itead/FishTank/Hardware/rboard pro-BOM.xls

PART_NUMBER | Ref Des | Qty | PCS | Description
00.23.01.0006 | C5 | 1 | 1 | CAP 0603 X7R 50V K 10nF
00.23.01.0007 | C4 | 1 | 1 | CAP 0603 X7R 50V K 3.9nF
00.23.01.0009 | C2,C3,C10,C14,C20,C21,C22,C23,C24,C28,C30,C31 | 12 | 1 | CAP 0603 X7R 50V K 100nF
00.23.01.0011 | C11,C12,C15,C18 | 4 | 1 | CAP 0603 NP0 50V J 12pF
00.23.01.0016 | C17,C29 | 2 | 1 | CAP 0603 X5R 25V K 10uF
00.23.03.0000 | C6,C7,C8,C13,C19,C25 | 6 | 1 | CAP 1206 X5R 10V K 22uF
00.27.06.0001 | S1,S2,S3 | 3 | 1 | 2p 6.1*3.7*2.5 TS-021
21010003 | U4 | 1 | 1 | ATMEGA2560-16AU TQFP100
21030004 | U3 | 1 | 1 | DS1307Z+ SOP8
21040002 | U8 | 1 | 1 | AMS1117-3.3 SOT223
21050001 | U1 | 1 | 1 | MPS MP2307DN SOP8N-T
22010000 | R34,R35,R37,R38 | 4 | 1 | RES 0603 J 0R
22010073 | R5,R13,R14,R15,R16,R17,R18,R19,R20,R21,R22,R23,R24,R25,R26,R36,R39 | 17 | 1 | RES 0603 J 1K
22010093 | R2 | 1 | 1 | RES 0603 J 6.8K
22010097 | R12 | 1 | 1 | RES 0603 J 10K
22010145 | R10,R11 | 2 | 1 | RES 0603 J 1M
22010634 | R3,R6,R7,R8,R9,R27,R28,R29,R30,R31 | 10 | 1 | RES 0603 F 10K
22010708 | R4 | 1 | 1 | RES 0603 F 44.2K
22010749 | R1 | 1 | 1 | RES 0603 F 100K
22030000 | R32 | 1 | 1 | RES 1206 J 0R
23100001 | C9,C26,C27 | 3 | 1 | CTAN E7343-43 10V M 470uF
23110001 | C1 | 1 | 1 | CAL D6.3L7.7 105 M 25V 100uF
24030001 | L1 | 1 | 1 | SPL 5.2X5.2 3A 5% 10uH
25010001 | D12,D13,D14,D15 | 4 | 1 | W TOSHIBA 1N4148 LL-34
25010002 | D1,D2,D3 | 3 | 1 | S TOSHIBA 1N5819 DO214AC
25210001 | Q1,Q2,Q3,Q4,Q5,Q6,Q7 | 7 | 1 | MOS_N JSCD SI2302 SOT23
25310000 | D6,D17,D18 | 3 | 1 | LED_SLED GREEN 0603
25310001 | D4,D7,D8,D9,D10,D11 | 6 | 1 | LED_SLED RED 0603
26010009 | X2 | 1 | 1 | SXTAL 16MHz 12.9X4.7X4.0 2PIN
26010012 | X1 | 1 | 1 | SXTAL 32.768KHz 3.2X1.5X0.8 2PIN
27030000 | K1,K2,K3,K4 | 4 | 1 | HK3FF|HUIKE|10A|1P2T|19X15.5X15.8mm
28010000 | F1 | 1 | 1 | PTC 500mA 1206
29010007 | J2,J3,J4,J5,J6,J7,J8,J9,J10,J11,J12,J13,J14,J15,J16,J17 | 16 | 3 | 40p 2.54 直插 黑 铜 直
29010007 | J19,J20,J21,J22 | 4 | 4 | 40p 2.54 直插 黑 铜 直
29010007 | J31 | 1 | 2 | 40p 2.54 直插 黑 铜 直
29010011 | J24 | 1 | 3 | 2*40p 2.54 直插 黑 铜 直
29010011 | J25 | 1 | 2 | 2*40p 2.54 直插 黑 铜 直
29020002 | J33 | 1 | 1 | 7p 2.54 直插 黑 铜 弯 3
29020007 | J23 | 1 | 1 | 2*4p 2.54 直插 黑 铜 直 3
29020013 | A1 | 1 | 2 | 10p 2.00 直插 黑 铜 直 3
29060001 | J26 | 1 | 1 | 2p 8A 5 绿
29060002 | J27,J28,J29,J30,J32 | 5 | 1 | 3p 8A 5 蓝
29070000 | J1 | 1 | 1 | 2 DC-005 6.4 直插
29110001 | B1 | 1 | 1 | CR1220-2 贴片
29150006 | J18 | 1 | 1 | MicroSD TF01A HTXY
/ | U2 | 1 | 1 | AC-DC 5V/1A
06.00.01.0031 | U5 | 1 | 1 | TLP521-4GB SOP16
 | U6 | 1 | 1 | PSA-BTA
00.21.20.0031 | U7 | 1 | 1 | 蓝牙4.0 HM-10
