itead/FishTank/(list of files, cad)

Other CAD files:
ShellPMMA/socket.dwg
ShellPMMA/screen.dwg
