itead/FishTank/(threads)

Thread 2 (2019-04-06):

screen refresh error

trk2010, 2019-04-06:
Hi,
I did this application.

The screen cannot be refreshed without resetting to arduino.
for example, entering the set page on the screen. When I click back home page, all information on home page is stretched as the default value of the screen.

ie the home page of the screen does not update the information without throwing arduino reset.
