itead/FishTank/Hardware/schematic - Rboard Pro.pdf

# POWER SUPPLY 22UF/10V/1206

# VCC5V

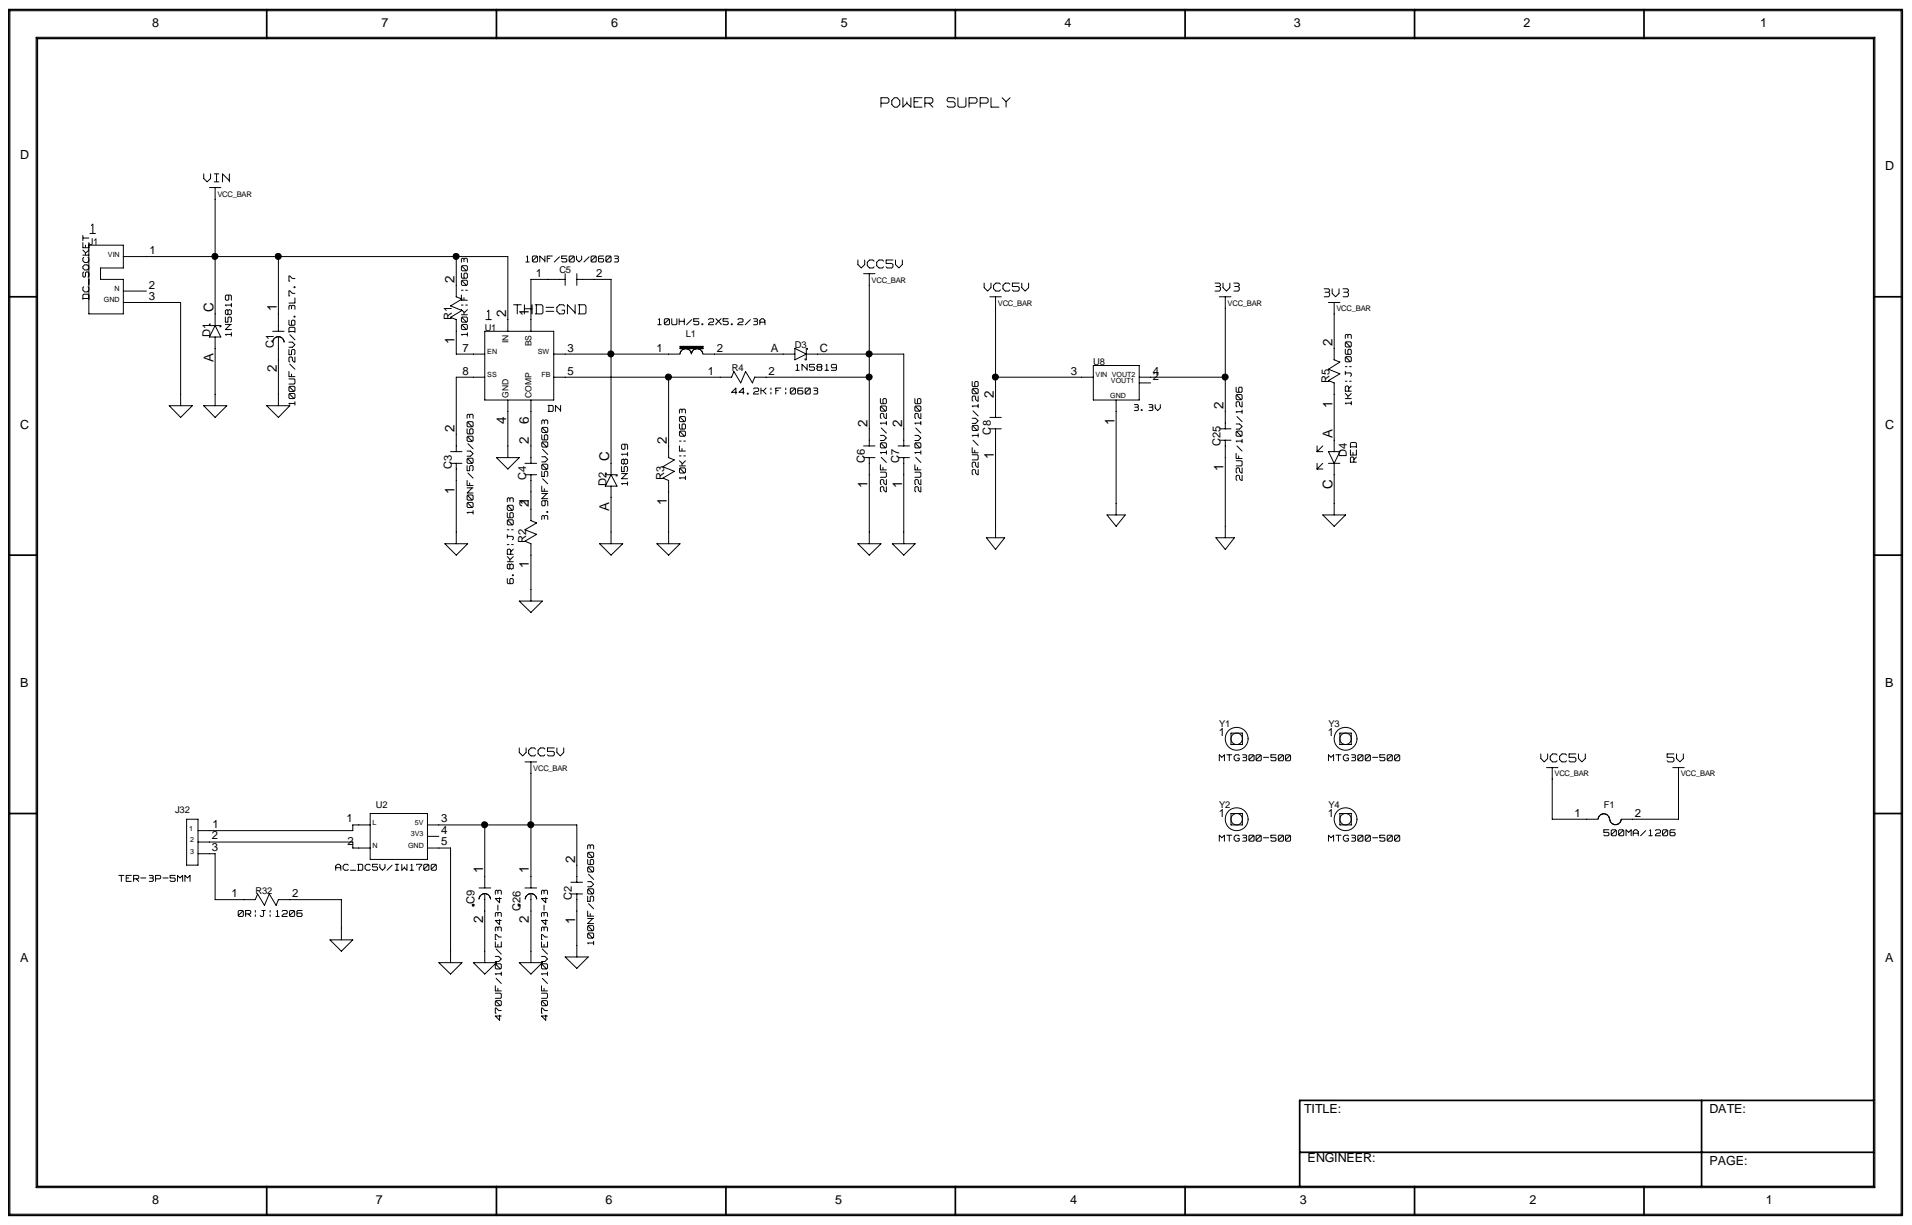
[picture p1: page 1]

TITLE: | DATE:

ENGINEER: | PAGE:

# VCC=3V3;AVCC=3V3

D

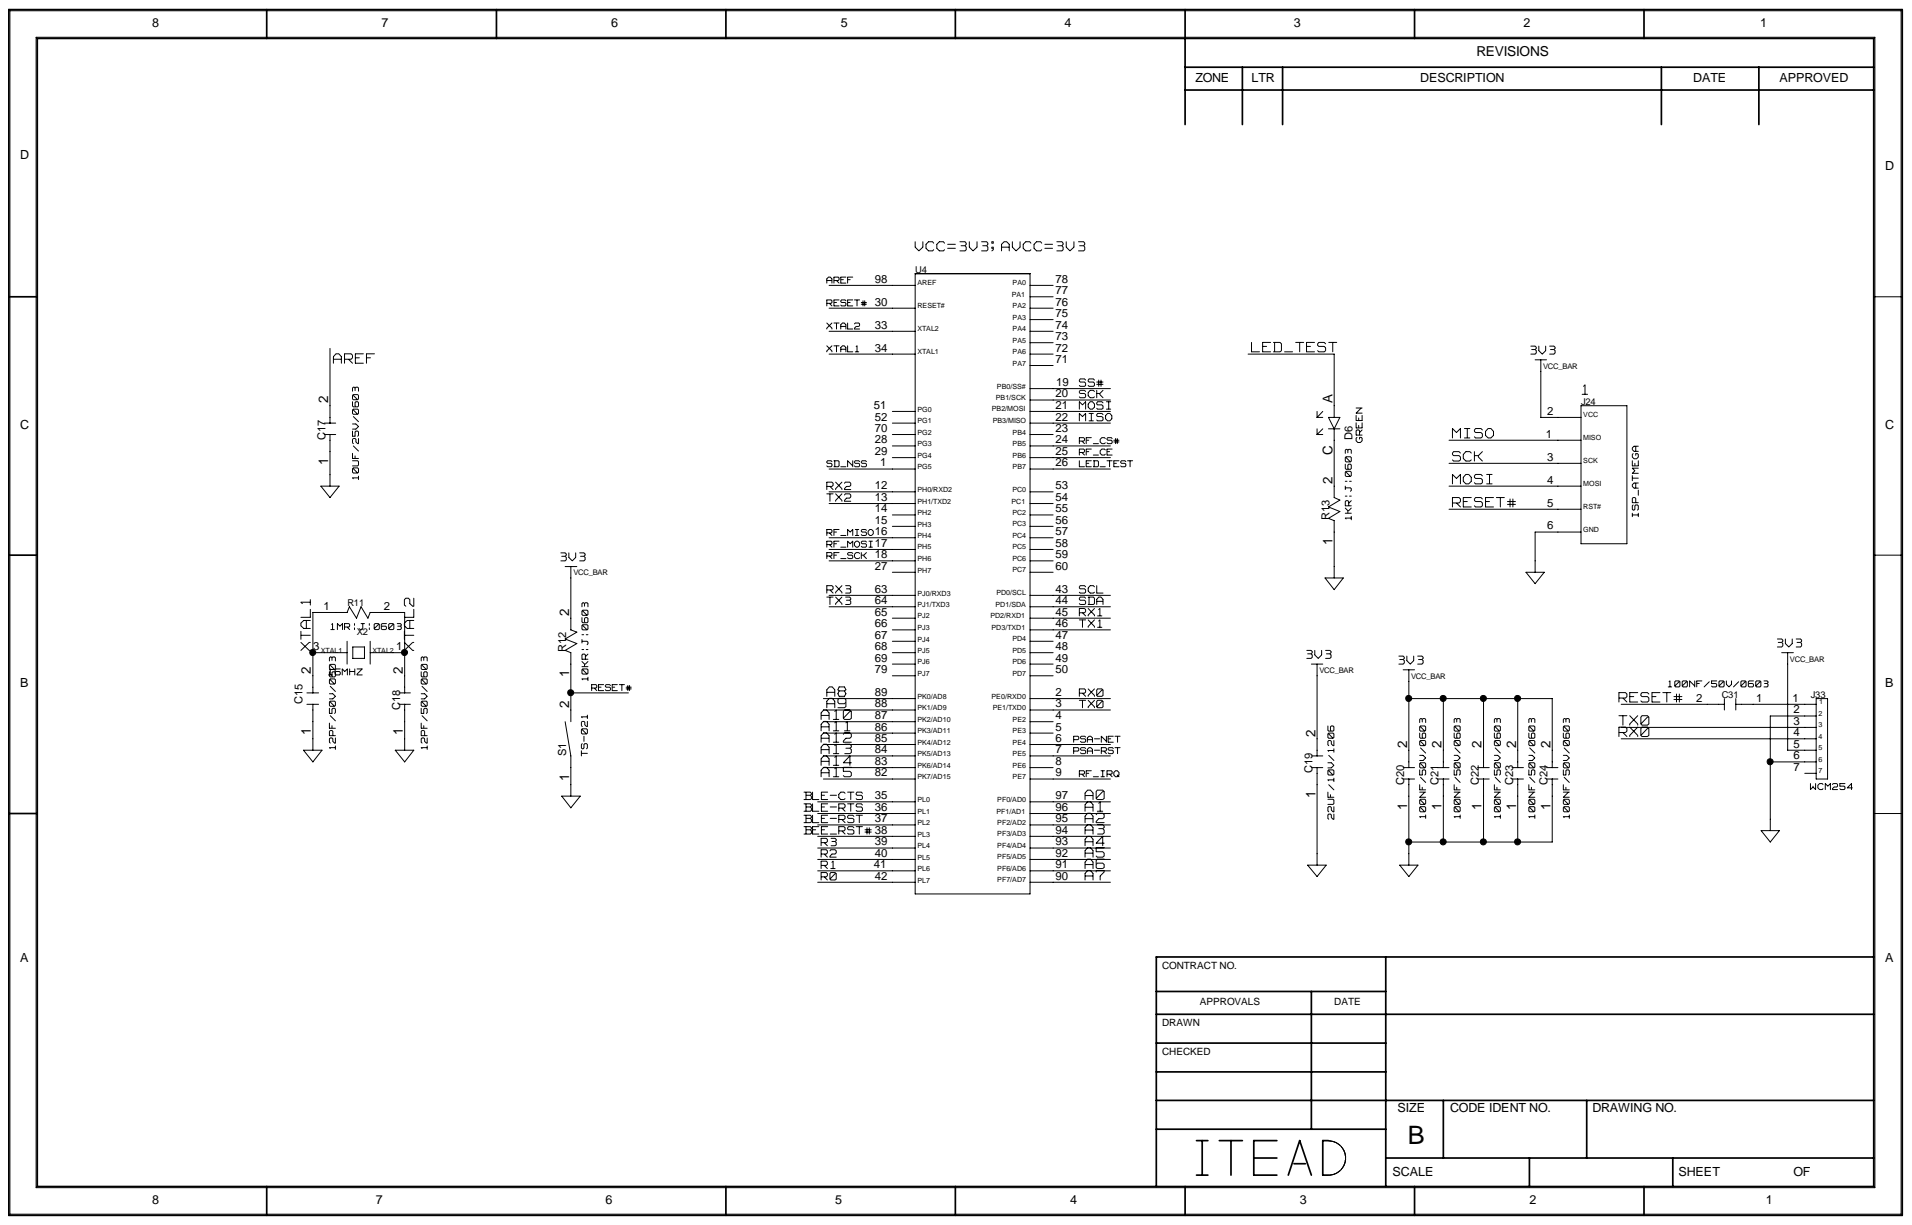
[picture p2: page 2]

3V3

# D-SDA

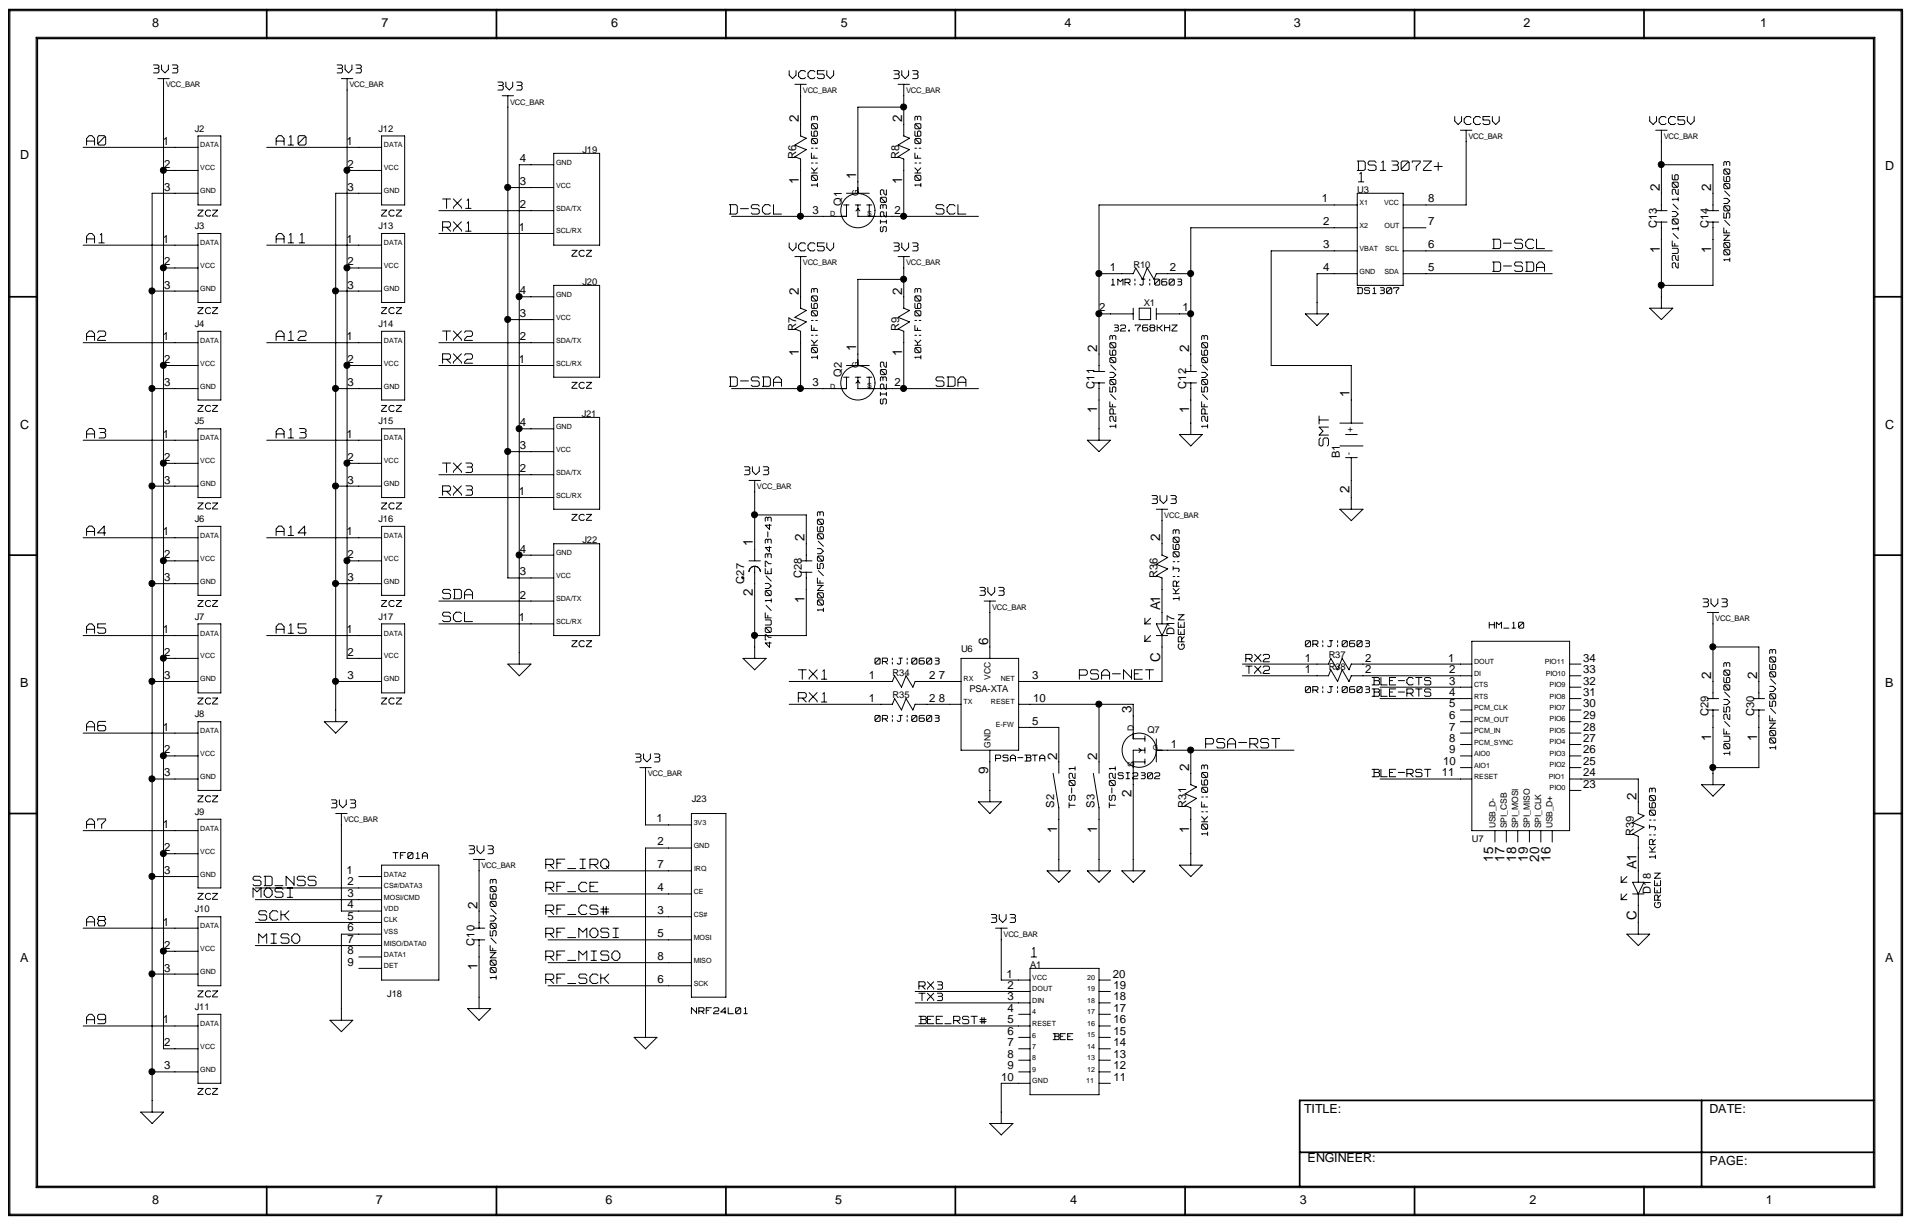
[picture p3: page 3]

TITLE: | D A TE:

ENGINEER: | PA GE:

# VDD_EXT

VDD_EXT | VDD_EXT

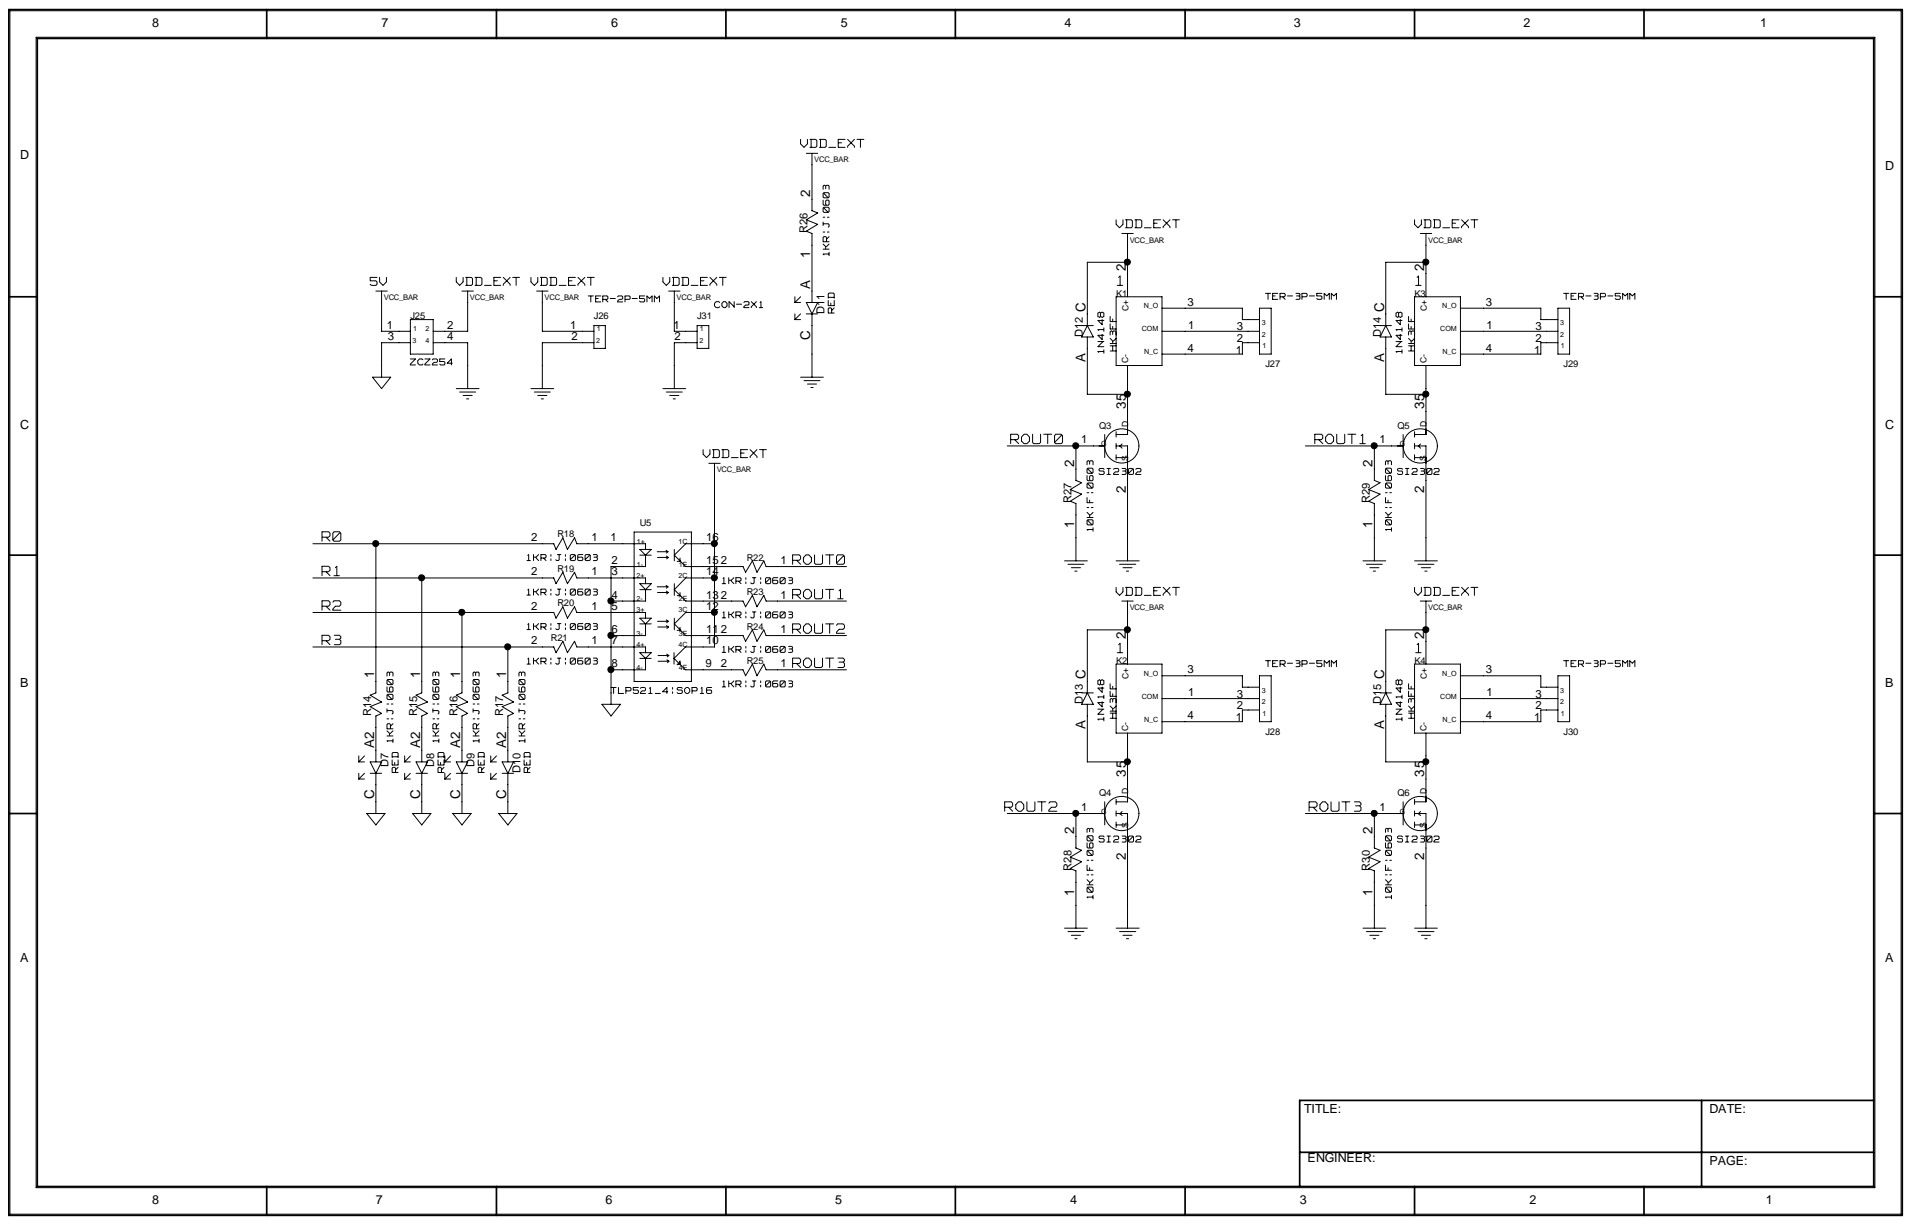
[picture p4: page 4]

TITLE: | D A TE:

ENGINEER: | PA GE:
