itead/FishTank/Hardware/assemblymap - Rboard Pro.pdf

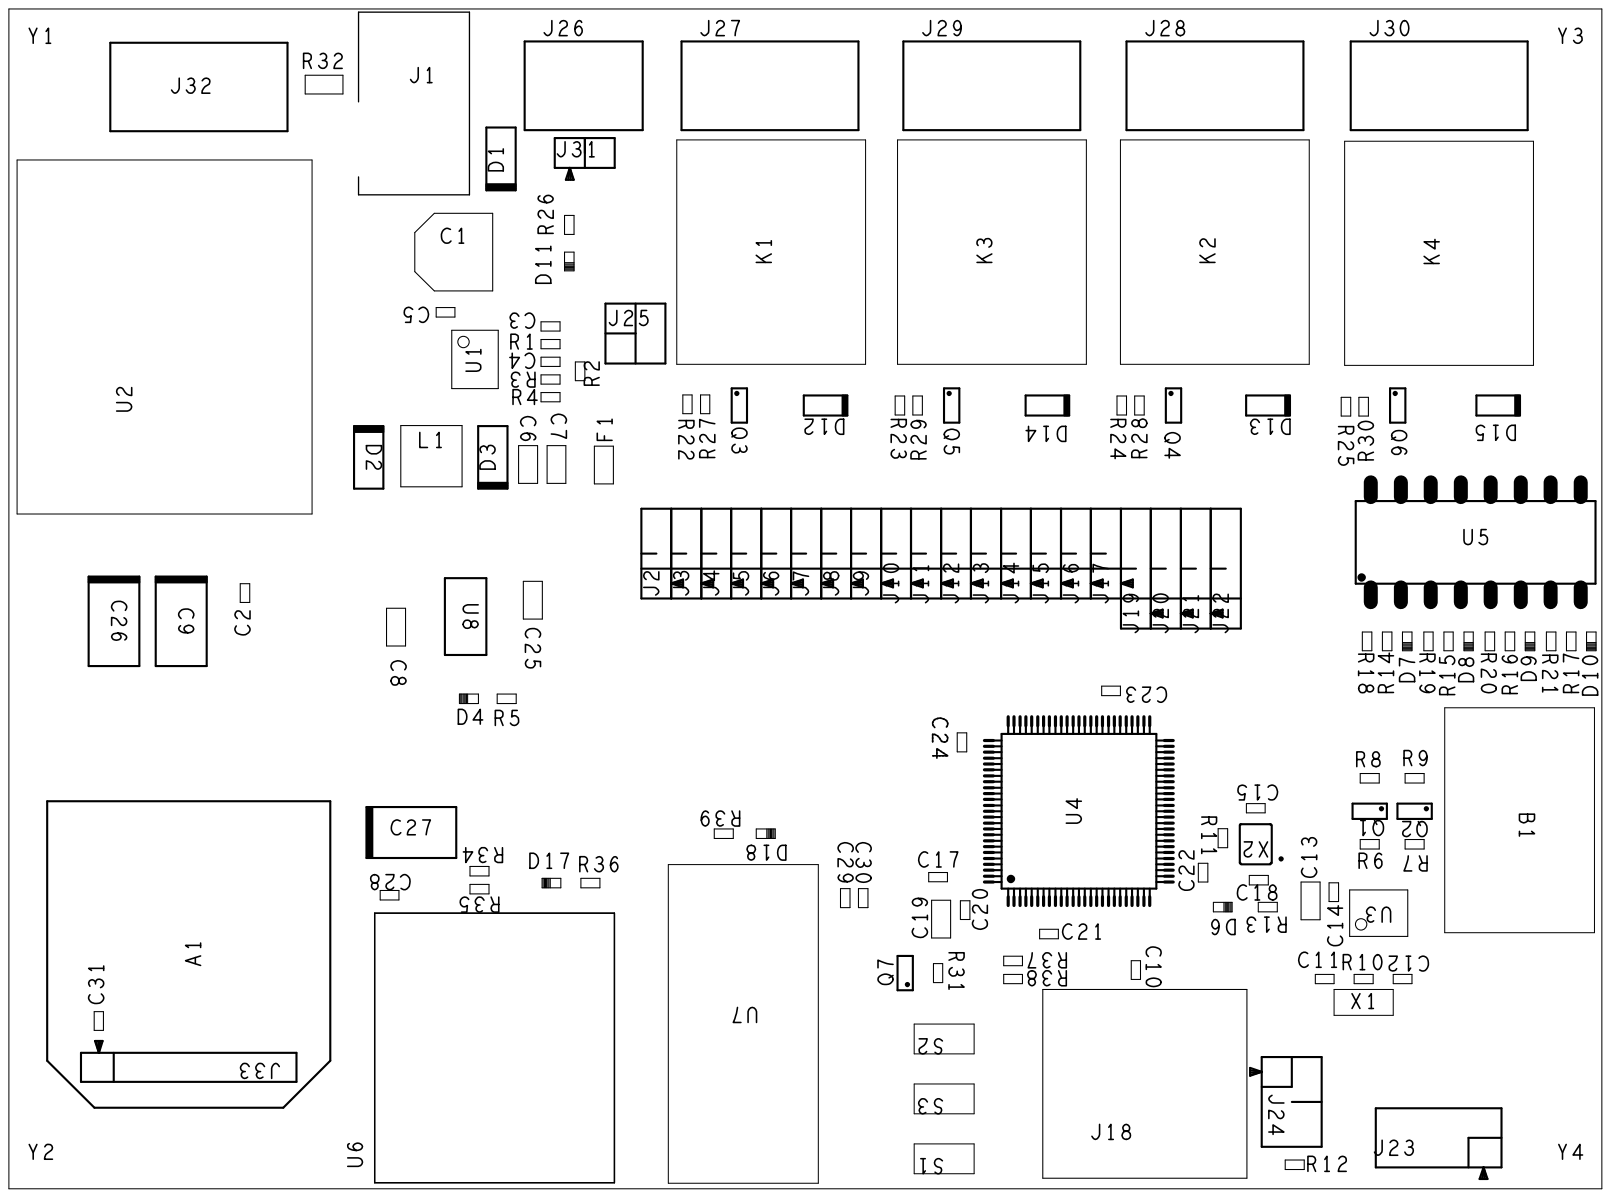
[picture p5: page 1]
