itead/FishTank/(notices)

Notices in the files:
Software/Source/FishTank/FishTank.ino:
Copyright (C) 2014-2015 ITEAD Intelligent Systems Co., Ltd. \n
modify it under the terms of the GNU General Public License as
published by the Free Software Foundation; either version 2 of
the License, or (at your option) any later version.
